benkuper/BenTo-Legacy/hardware/BentoPCB_V4_Front.png

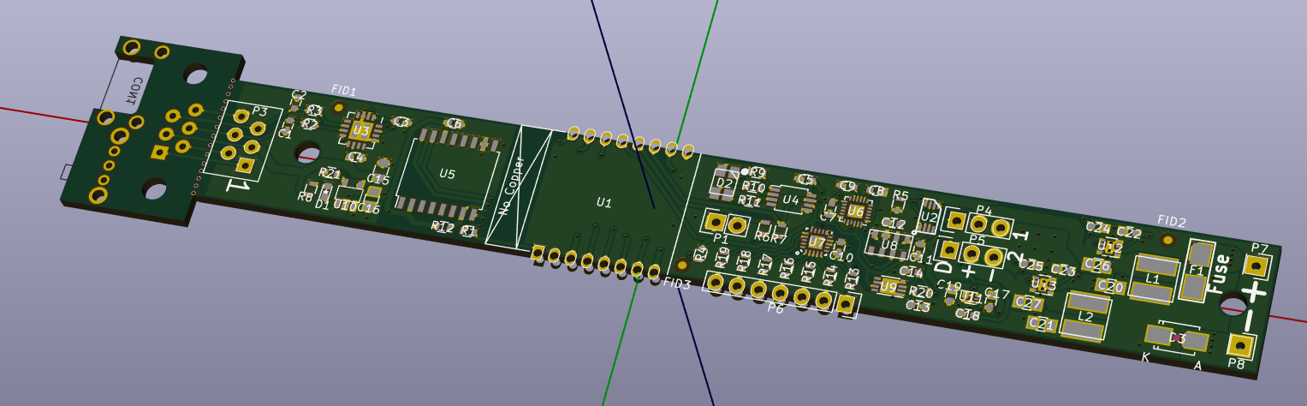
hardware/BentoPCB_V4_Front.png
