benkuper/BenTo-Legacy/hardware/BentoPCB_V4_Back.png

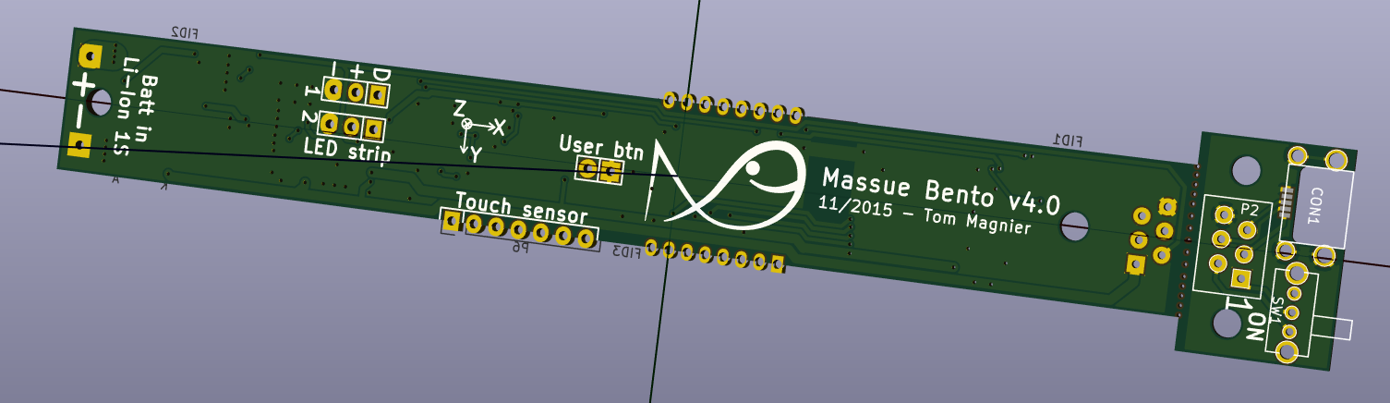
hardware/BentoPCB_V4_Back.png
