benkuper/BenTo-Legacy/README.md

# BenTo
Legacy repository for the Bento Clubs
