benkuper/BenTo-Legacy/hardware/BentoPCB_V4_layout.png

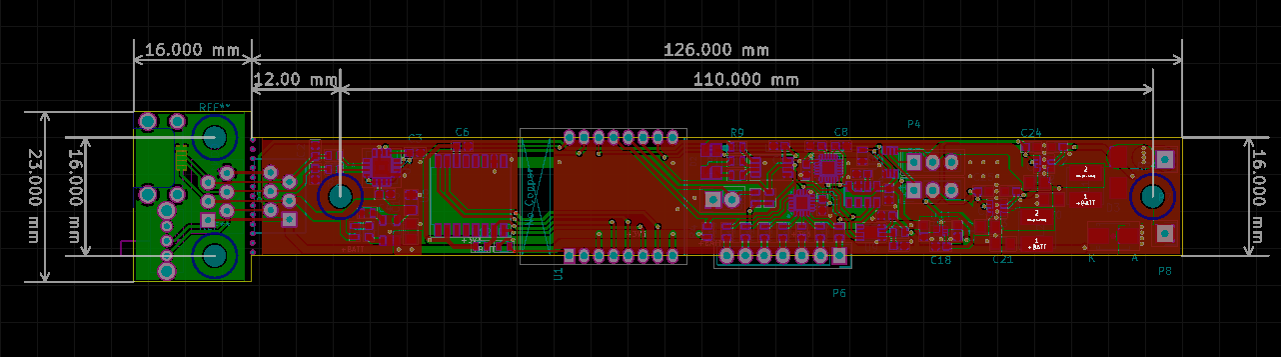
hardware/BentoPCB_V4_layout.png
