benkuper/BenTo-Legacy/hardware/prod/massue_bento_v4_BOM.ods

Reference | Qty | Designation | Package | Stock 17/06/16 | Mouser P/N | Mouser unit price (net, €, x1) | Mouser total price | Farnell P/N | Farnell unit price (net, €, x1) | Farnell total price
C1, C2 | 2 | 47pF | C_0603 | 2 | 77-VJ0603A470JXACBC (http://www.mouser.fr/ProductDetail/Vishay-Vitramon/VJ0603A470JXACW1BC/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) | 0,054 | 0,108 | 1759062 (http://fr.farnell.com/multicomp/mc0603n470j500ct/condensateur-mlcc-c0g-np0-47pf/dp/1759062) | 0,0097 | 0,0194
C3-C7,C9-C13,C18,C24,C25 | 13 | 0.1uF | C_0603 | 13 | VJ0603Y104JXJPW1BC (http://www.mouser.fr/ProductDetail/Vishay-Vitramon/VJ0603Y104JXJPW1BC/) | 0,054 | 0,702 | 1759037 (http://fr.farnell.com/multicomp/mc0603b104k250ct/condensateur-mlcc-0603-x7r-25v/dp/1759037) | 0,0073 | 0,0949
C8 | 1 | 10nF | C_0603 | 4 | VJ0603Y103KXAAC (http://www.mouser.fr/ProductDetail/Vishay-Vitramon/VJ0603Y103KXAAC/) | 0,045 | 0,045 | 1759102 (http://fr.farnell.com/multicomp/mc0603b103k500ct/condensateur-mlcc-0603-x7r-50v/dp/1759102) | 0,0073 | 0,0073
C14,C17,C19,C22,C23 | 5 | 2.2uF, 10V, X5R/X7R | C_0603 | 4 | 963-LMK107BJ225KA-T (http://www.mouser.fr/ProductDetail/Taiyo-Yuden/LMK107BJ225KA-T/) | 0,119 | 0,595 | 2320817 (http://fr.farnell.com/multicomp/mc0603x225k100ct/condensateur-mlcc-x5r-2-2uf-10v/dp/2320817) | 0,0214 | 0,107
C15,C16 | 2 | 10uF | C_0805 | 3 | 80-C0805C106M4P (http://www.mouser.fr/ProductDetail/Kemet/C0805C106M4PACTU/) | 0,19 | 0,38 | 2320856 (http://fr.farnell.com/multicomp/mc0805x106k160ct/condensateur-mlcc-x5r-10uf-16v/dp/2320856) | 0,0945 | 0,189
C20,C21 | 2 | 4.7uF, 10V, X5R/X7R | C_0805 | 3 | 81-GRM219R61C475KE5D (http://www.mouser.fr/ProductDetail/Murata-Electronics/GRM219R61C475KE15D/) | 0,154 | 0,308 | 1759420 (http://fr.farnell.com/multicomp/mc0805x475k100ct/condensateur-mlcc-x5r-4-7uf-10v/dp/1759420) | 0,0709 | 0,1418
C26,C27 | 2 | 22uF, 10V, ESR < 10mR, X5R/X7R | C_0805 | 3 | 603-CC805MKX5R6BB226 (http://www.mouser.fr/ProductDetail/Yageo/CC0805MKX5R6BB226/?qs=sGAEpiMZZMvsSlwiRhF8qmGKz53ivRjhfoOY2sHMRaQ%3D) | 0,274 | 0,548 | 2494270 (http://fr.farnell.com/murata/grm21br61a226me51l/condens-mlcc-x5r-22uf-10v-0805/dp/2494270) | 0,226 | 0,452
CON1 | 1 | USB-MICRO-B | Molex 47642-0001 |  | 538-47642-0001 (http://www.mouser.fr/ProductDetail/Molex/47642-0001/?qs=sGAEpiMZZMvix4Kz%252byXAvU6WIa4V4G4m) | 0,697 | 0,697 | 2396171 (http://fr.farnell.com/molex/47642-0001/connecteur-usb-micro-b-rcpt-5pos/dp/2396171) | 0,828 | 0,828
D1 | 1 | Red | LED-0603 | 7 |  | 0,091 | 0,091 | 8529833 (http://fr.farnell.com/kingbright/kp-1608sgc/led-cms-0603-vert/dp/8529833) | 0,079 | 0,079
D2 | 1 | Cree CLV1A | PLCC-4 |  | 941-V1AFKBCHMKPEH7A3 (http://www.mouser.fr/ProductDetail/Cree-Inc/CLV1A-FKB-CHMKPEHBB7A363/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) | 0,366 | 0,366 | 1855553 (http://fr.farnell.com/cree/clv1a-fkb-cj1m1f1bb7r4s3/led-plcc4-multi-colour/dp/1855553) | 0,505 | 0,505
D3 | 1 | PMEG4050EP | SMA_Standard |  | 771-PMEG4050EP115 (http://www.mouser.fr/ProductDetail/NXP-Semiconductors/PMEG4050EP115/) | 0,462 | 0,462 | 1829203 (http://fr.farnell.com/nxp/pmeg4050ep/diode-schottky-redr-40v-5a-sod128/dp/1829203) | 0,568 | 0,568
F1 | 1 | SMD FUSE, 8A | Fuse_SMD1206 | 1 | 637-F1206FA8000V024 (http://www.mouser.fr/ProductDetail/AEM/F1206FA8000V024T/) | 0,259 | 0,259 | 1843815 (http://fr.farnell.com/te-connectivity-raychem/1206sff800f-24-2/fuse-smd-1206-8a/dp/1843815) | 0,461 | 0,461
L1,L2 | 2 | 1uH, 4.5A (LQH5BPN1R0NT0L) | LQH5BP_Murata_ind |  | 81-LQH5BPN1R0NT0L0L (http://www.mouser.fr/ProductDetail/Murata-Electronics/LQH5BPN1R0NT0L/) | 0,443 | 0,886 | 2219299 (http://fr.farnell.com/murata/lqh5bpn1r0nt0l/inductance-puissance-1-0uh-30/dp/2219299) | 0,338 | 0,676
P2,P3 | 2 | CONN_01X06 | MOLEX 90325-0006 | 6 | 538-90325-0006 (http://www.mouser.fr/ProductDetail/Molex/90325-0006/?qs=sGAEpiMZZMulHKv6iWKM9N6rysiRsaER) | 0,33 | 0,66 | 673225 (http://fr.farnell.com/molex/90325-0006/embase-picoflex-6v/dp/673225) | 0,385 | 0,77
P2b | 1 |  | MOLEX 90327-0306 |  | 538-90327-0306 (http://www.mouser.fr/ProductDetail/Molex/90327-0306/?qs=sGAEpiMZZMvvAo%252bip5liN%252b%252bGt31S2ldP) | 0,659 | 0,659 | 673158 (http://fr.farnell.com/molex/90327-0306/connecteur-picoflex-6v/dp/673158) | 0,186 | 0,186
R1,R4-R7,R13-R19 | 12 | 10k | R_0603 | 9 | 71-CRCW0603-10K-E3 (http://www.mouser.fr/ProductDetail/Vishay-Dale/CRCW060310K0FKEA/) | 0,072 | 0,864 | 9238603 (http://fr.farnell.com/yageo-phycomp/rc0603fr-0710kl/resistance-rc22h-0603-10k/dp/9238603) | 0,0064 | 0,0768
R2,R3 | 2 | 27R | R_0603 | 3 | 71-CRCW060327R0JNEB (http://www.mouser.fr/ProductDetail/Vishay-Dale/CRCW060327R0JNEB/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) | 0,072 | 0,144 | 2447316 (http://fr.farnell.com/multicomp/mcwr06x27r0ftl/resistance-couche-epaisse-27r/dp/2447316) | 0,0013 | 0,0026
R8 | 1 | 1k | R_0603 | 4 | 71-CRCW0603-1.0K-E3 (http://www.mouser.fr/ProductDetail/Vishay-Dale/CRCW06031K00FKEA/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) | 0,072 | 0,072 | 9330380 (http://fr.farnell.com/multicomp/mc0063w060311k/resistance-1k-0-063w-1-0603/dp/9330380) | 0,037 | 0,037
R9 | 1 | 220R | R_0603 | 5 | 594-MCT06030C2200FP5 (http://www.mouser.fr/ProductDetail/Vishay-Beyschlag/MCT06030C2200FP500/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) | 0,054 | 0,054 | 1652858 (http://fr.farnell.com/vishay-draloric/crcw0603220rjnea/resistance-couche-epaisse/dp/1652858) | 0,0064 | 0,0064
R10,R11 | 2 | 100R | R_0603 |  | 71-CRCW0603-100-E3 (http://www.mouser.fr/ProductDetail/Vishay-Dale/CRCW0603100RFKEA/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) | 0,072 | 0,144 | 9330364 (http://fr.farnell.com/multicomp/mc0063w06031100r/resistance-0603-100r/dp/9330364) | 0,007 | 0,014
R12 | 1 | 100k | R_0603 | 5 | 71-CRCW0603-100K-E3 (http://www.mouser.fr/ProductDetail/Vishay-Dale/CRCW0603100KFKEA/) | 0,072 | 0,072 | 9330402 (http://fr.farnell.com/multicomp/mc0063w06031100k/resistance-100k-0-063w-1-0603/dp/9330402) | 0,037 | 0,037
R21 | 1 | 2k | R_0603 | 6 | 71-CRCW0603-2.0K-E3 (http://www.mouser.fr/ProductDetail/Vishay-Dale/CRCW06032K00FKEA/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) | 0,091 | 0,091 | 9330763 (http://fr.farnell.com/multicomp/mc0063w060312k/resistance-2k-0-063w-1-0603/dp/9330763) | 0,012 | 0,012
SW1 | 1 | SWITCH_INV | OS102011MA1QN1 |  | 611-OS102011MA1QN1 (http://www.mouser.fr/ProductDetail/CK-Components/0S102011MA1QN1/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) | 0,42 | 0,42 | 1201431 (http://fr.farnell.com/c-k-components/os102011ma1qn1/emission-laterale-commutateur/dp/1201431) | 0,675 | 0,675
U1 | 1 | ESP-07v2 | ESP-07v2 |  |  |  | 0 |  |  | 0
U2 | 1 | SN74LVC2T45DCU | VSSOP-8 |  | 595-SN74LVC2T45DCUR (http://www.mouser.fr/ProductDetail/Texas-Instruments/SN74LVC2T45DCUR/) | 0,652 | 0,652 | 2499858 (http://fr.farnell.com/texas-instruments/sn74lvc2t45qdcurq1/transceiver-2bits-sortie-3-etats/dp/2499858) | 0,511 | 0,511
U3 | 1 | FT230XQ | QFN-16-1EP_4x4mm_Pitch0.65mm |  | 895-FT230XQ-R (http://www.mouser.fr/ProductDetail/FTDI/FT230XQ-R/?qs=sGAEpiMZZMvVkErl6zY%252bqeI5xuGNHfx4) | 1,87 | 1,87 | 2081324 (http://fr.farnell.com/ftdi/ft230xq/i-f-usb2-0-fs-to-bascircuit-uart/dp/2081324) | 1,94 | 1,94
U4 | 1 | PCA9632DP1 | TSSOP-8_3x3mm_Pitch0.65mm |  | 771-PCA9632DP1118 (http://www.mouser.fr/ProductDetail/NXP-Semiconductors/PCA9632DP1118/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) | 1,26 | 1,26 |  |  | 0
U5 | 1 | S25FL512S**M | SOIC-16_7.5x10.3mm_Pitch1.27mm |  | 797-25FL512SAGMFIG11 (http://www.mouser.fr/ProductDetail/Spansion/S25FL512SAGMFIG11/) | 5,39 | 5,39 | 2340548 (http://fr.farnell.com/spansion/s25fl512sagmfig11/memoire-flash-512mb-16soic/dp/2340548) | 6,73 | 6,73
U6 | 1 | MPU9250 | QFN-24-1EP_3x3mm_Pitch0.4mm |  |  |  | 0 |  |  | 0
U7 | 1 | AT42QT1070-MMH | QFP_20_3x3mm_0.45mm_pitch |  | 556-AT42QT1070-MMH (http://www.mouser.fr/ProductDetail/Atmel/AT42QT1070-MMH/) | 1,74 | 1,74 |  |  | 0
U8 | 1 | MPL3115A2 | LGA8 |  | 841-MPL3115A2 (http://www.mouser.fr/ProductDetail/Freescale-Semiconductor/MPL3115A2/?qs=sGAEpiMZZMu5STvjs3TtKqOY2b8Izg8b) | 2,98 | 2,98 | 2009084 (http://fr.farnell.com/freescale-semiconductor/mpl3115a2/pressure-sensor-20-110kpa-8lga/dp/2009084) | 2,64 | 2,64
U9 | 1 | LC709203F | WDFN-8-1EP_3x4mm_Pitch0.65mm |  | 863-LC709203FQH01TWG (http://www.mouser.fr/ProductDetail/ON-Semiconductor/LC709203FQH-01TWG/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) | 1,47 | 1,47 |  |  | 0
U10 | 1 | MCP73832***/OT | SOT-23-5 | 2 | 579-MCP73832T2DFI/OT (http://www.mouser.fr/ProductDetail/Microchip-Technology/MCP73832T-2DFI-OT/?qs=sGAEpiMZZMvAvBNgSS9Lqry4bkuQioGQ) | 0,543 | 0,543 | 1834892 (http://fr.farnell.com/microchip/mcp73832t-2dci-ot/batt-charger-li-ion-li-poly-5sot23/dp/1834892) | 0,53 | 0,53
U11 | 1 | MIC5528-3.3YMT | DFN-6-1EP_1.2x1.2mm_Pitch0.4mm | 2 | 998-MIC5528-3.3YMTTR (http://www.mouser.fr/ProductDetail/Micrel/MIC5528-33YMT-TR/) | 0,525 | 0,525 | 2451762 (http://fr.farnell.com/micrel-semiconductor/mic5528-3-3ymt-tr/ldo-volt-reg-0-5a-3-3v-tdfn-6/dp/2451762) | 0,238 | 0,238
U12,U13 | 2 | MIC2876-5.0YMT | DFN-8-1EP_2x2mm_Pitch0.5mm | 2 | 998-MIC2876-50YMTT5 (http://www.mouser.fr/ProductDetail/Micrel/MIC2876-50YMT-T5/?qs=sGAEpiMZZMvJkDqKJH80dCXDytGmYK1ioJlrXRr9Mlw%3D) | 1,45 | 2,9 |  |  | 0
TOTAL |  |  |  |  |  |  | 27,957 |  |  | 18,5342
acheter en plus : nappe |  |  |  |  | 538-92315-0620 (http://www.mouser.fr/ProductDetail/Molex/92315-0620/?qs=sGAEpiMZZMuw1rG4%252bG7fppmX45GF4%252bkx) | 1,24 |  | 3032140 | 1,86
