benkuper/BenTo-Legacy/hardware/massue_bento_v4.pdf

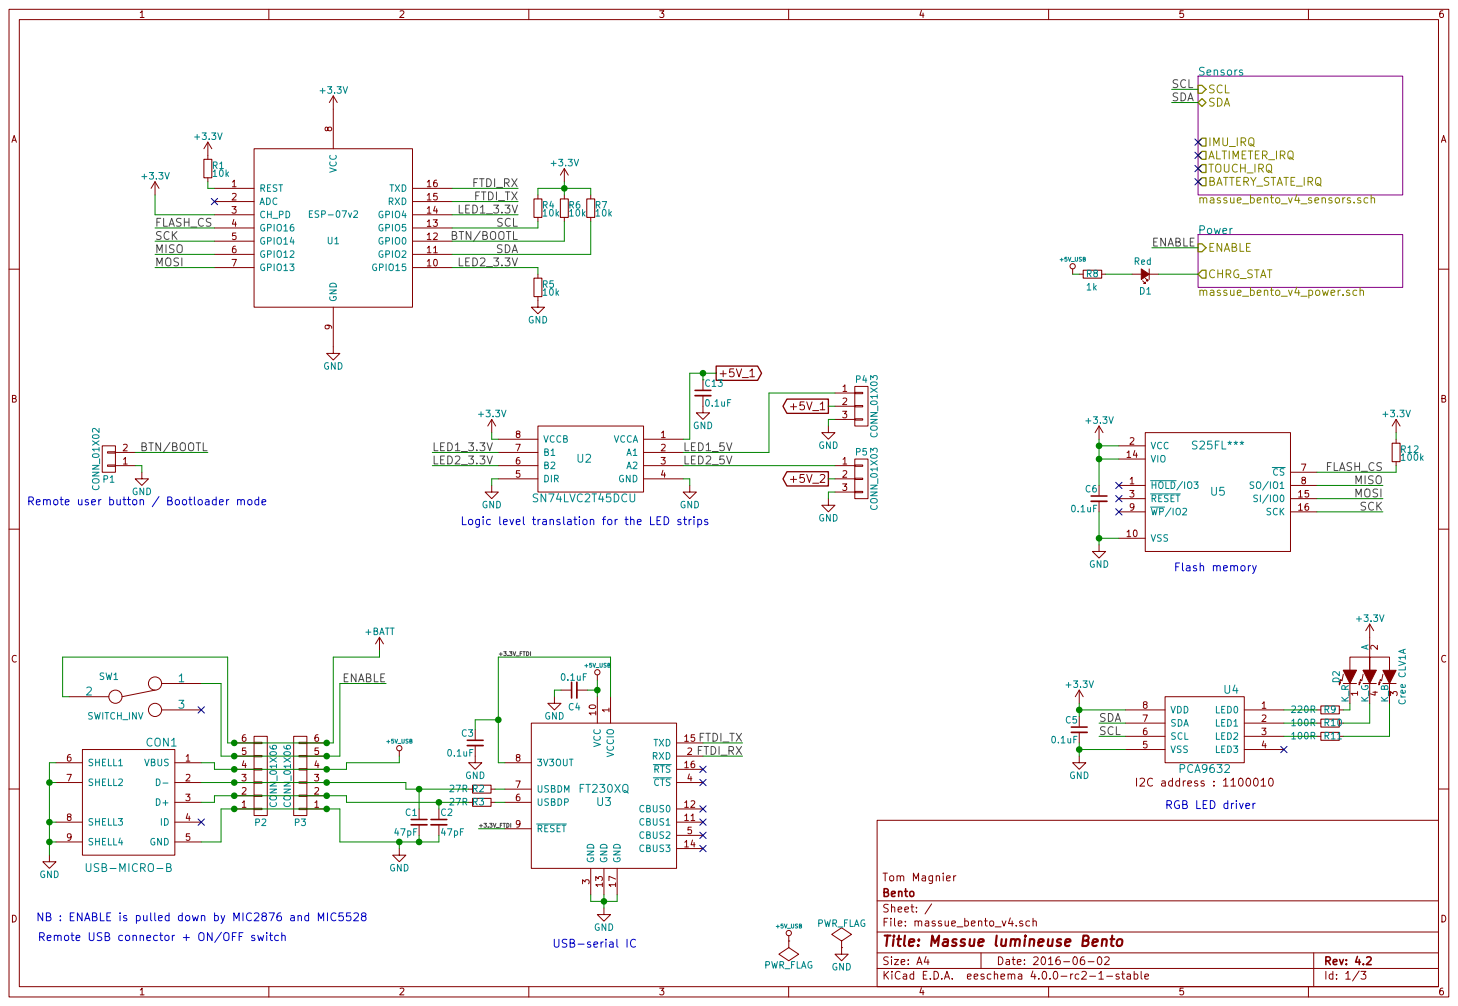
[picture p4: page 1]

9 GPIO15 10 GPIO2 11 GPIO0 12 GPIO5 13 GPIO4 14 RXD 15 TXD 16 U1 ESP-07v2 HOLD/IO3 1 VCC 2 RESET 3 CS 7 SO/IO1 8 WP/IO2 9 VSS 10 VIO 14 SI/IO0 15 SCK 16 U5 S25FL*** VBUS 1 D- 2 D+ 3
10k GND FLASH_CS

Remote user button / Bootloader mode

Logic level translation for the LED strips

Tom Magnier
File: massue_bento_v4.sch Sheet: / Bento

Id: 1/3 Title: Massue lumineuse Bento

Remote USB connector + ON/OFF switch

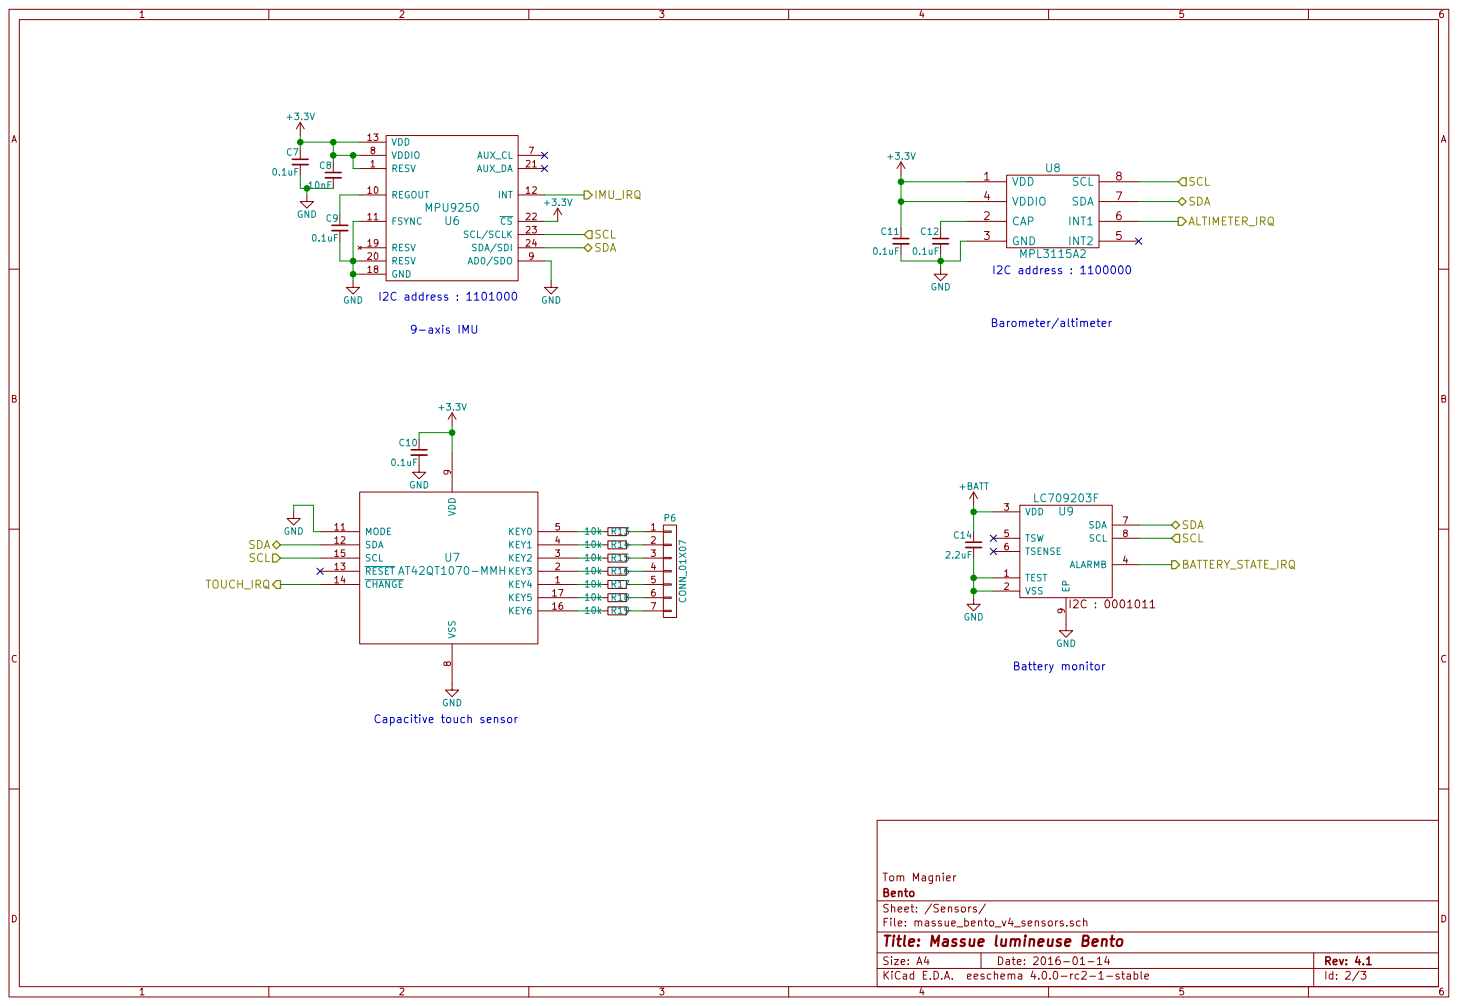
[picture p5: page 2]

9 MODE 11 SDA 12 RESET 13 CHANGE 14 SCL 15 KEY6 16 KEY5 17 U7 AT42QT1070-MMH

Capacitive touch sensor GND GND SCL
SDA

Tom Magnier
File: massue_bento_v4_sensors.sch Sheet: /Sensors/ Bento

Id: 2/3 Title: Massue lumineuse Bento

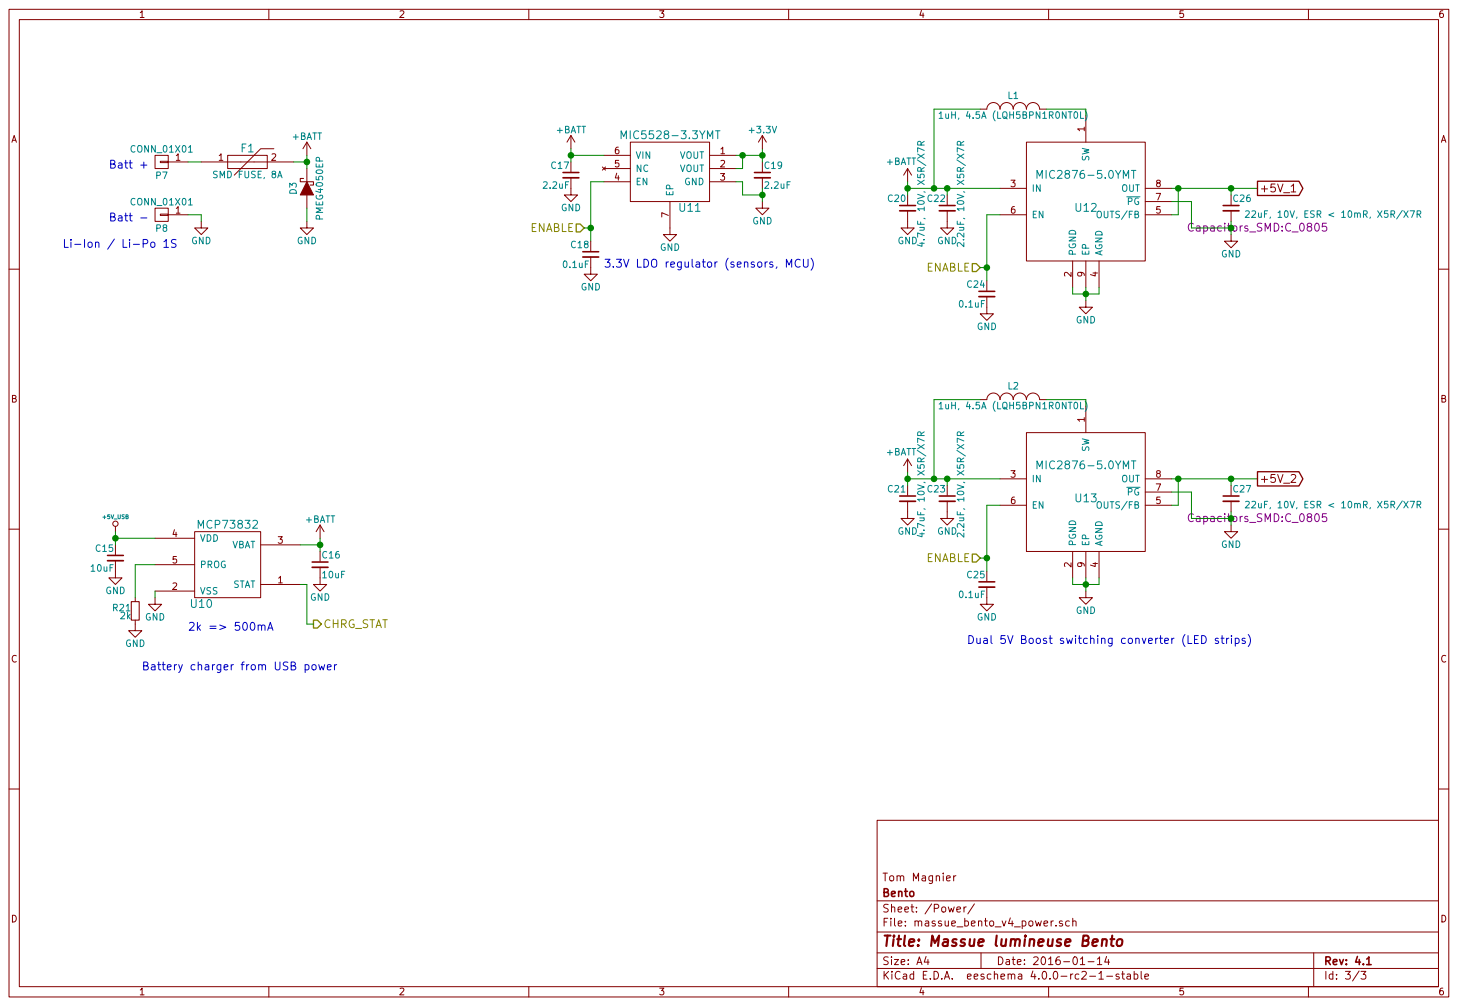
[picture p6: page 3]

1 P8 CONN_01X01 Batt + Batt - Li-Ion / Li-Po 1S

4 OUTS/FB 5 EN 6 PG 7 OUT 8 EP

3.3V LDO regulator (sensors, MCU) GND

10uF GND Battery charger from USB power

GND
Dual 5V Boost switching converter (LED strips)

File: massue_bento_v4_power.sch Sheet: /Power/ Bento

Id: 3/3 Title: Massue lumineuse Bento
