benkuper/BenTo-Legacy/hardware/prod/massue_bento_v4-brd.pdf

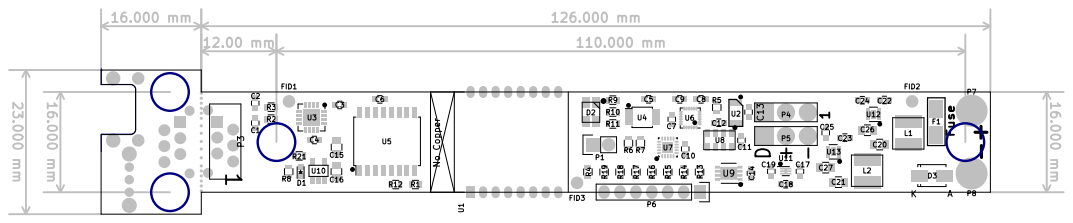
[picture p7: page 1]
