benkuper/BenTo-Legacy/hardware/massue_bento_v4.kicad_pcb

## KiCad design hardware/massue_bento_v4.kicad_pcb (2017-02-13)

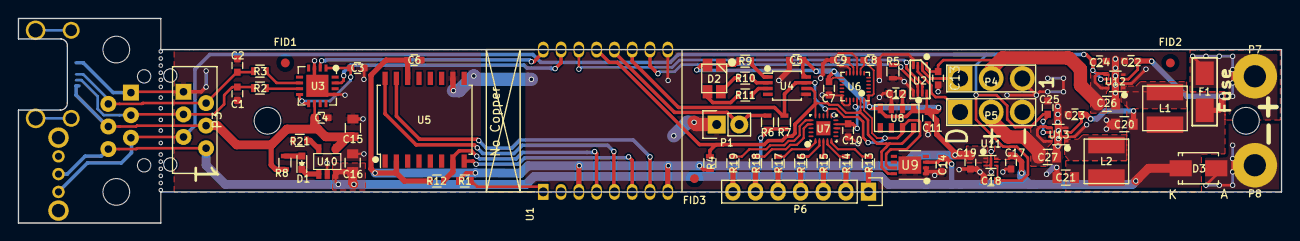
[picture p8: board massue_bento_v4.kicad_pcb from above]

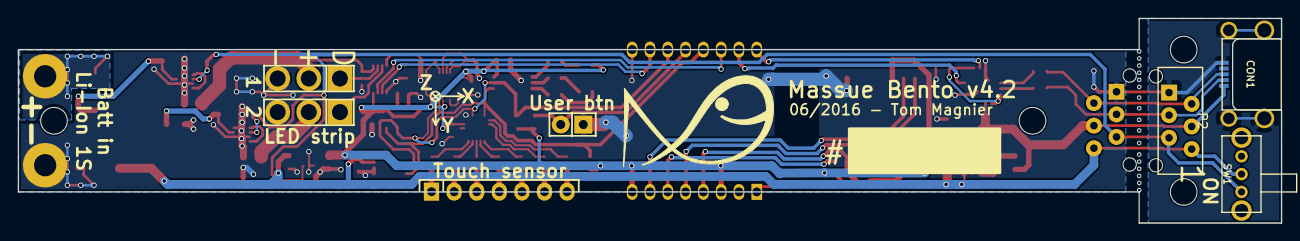
[picture p9: board massue_bento_v4.kicad_pcb from below]

Board: 2 copper layers, 142.0 x 23.0 mm, 79 parts (3 on the bottom side), 54 nets.

Parts:
C1, C2: 47pF; C_0603
C3, C4, C5, C6, C7, C9, C10, C11, C12, C13, C18, C24, C25: 0.1uF; C_0603
C8: 10nF; C_0603
C14, C17, C19: 2.2uF; C_0603
C15, C16: 10uF; C_0805
C20, C21: 4.7uF, 10V, X5R/X7R; C_0805
C22, C23: 2.2uF, 10V, X5R/X7R; C_0603
C26, C27: 22uF, 10V, ESR < 10mR, X5R/X7R; C_0805
CON1: USB-MICRO-B; MICRO_USB_B_MIDMOUNT_TH
D1: Red; LED-0603
D2: Cree CLV1A; PLCC-4
D3: PMEG4050EP; SMA_Standard
F1: SMD FUSE, 8A; Fuse_SMD1206_HandSoldering
FID1, FID2, FID3: Fiducial_very_small_modern
L1, L2: 1uH, 4.5A (LQH5BPN1R0NT0L); LQH5BP_Murata_ind
P1: CONN_01X02; Socket_Strip_Straight_1x02
P2, P3: CONN_01X06; MOLEX_90325-0006
P4, P5: CONN_01X03; Conn_1x03_1-8mmDrill
P6: CONN_01X07; Socket_Strip_Straight_1x07
P7, P8: CONN_01X01; SolderWirePad_single_2-5mmDrill
R1, R4, R5, R6, R7, R13, R14, R15, R16, R17, R18, R19: 10k; R_0603
R2, R3: 27R; R_0603
R8: 1k; R_0603
R9: 220R; R_0603
R10, R11: 100R; R_0603
R12: 100k; R_0603
R21: 2k; R_0603
SW1: SWITCH_INV; SPDT_MINI_SLIDE_SWITCH
U1: ESP-07v2
U2: SN74LVC2T45DCU; VSSOP-8
U3: FT230XQ; QFN-16-1EP_4x4mm_Pitch0.65mm
U4: PCA9632; TSSOP-8_3x3mm_Pitch0.65mm
U5: S25FL***; SOIC-16_7.5x10.3mm_Pitch1.27mm
U6: MPU9250; QFN-24-3x3mm_Pitch0.4mm
U7: AT42QT1070-MMH; QFP_20_3x3mm_0.45mm_pitch
U8: MPL3115A2; LGA8
U9: LC709203F; WDFN-8-1EP_3x4mm_Pitch0.65mm
U10: MCP73832; SOT-23-5
U11: MIC5528-3.3YMT; DFN-6-1EP_1.2x1.2mm_Pitch0.4mm
U12, U13: MIC2876-5.0YMT; DFN-8-1EP_2x2mm_Pitch0.5mm

Connections:
+3V3: C5.1, C6.1, C7.1, C8.1, C10.1, C11.1, C19.1, D2.2, R1.1, R4.1, R6.1, R7.1, R12.1, U1.3, U1.8, U2.8, U4.8, U5.2, U5.14, U6.1, U6.8, U6.13, U6.22, U7.9, U8.1, U8.4, U11.1, U11.2
+5V_1: C13.1, C26.1, P4.2, U2.1, U12.5, U12.8
+5V_2: C27.1, P5.2, U13.5, U13.8
+5V_USB: C4.2, C15.1, CON1.1, P2.4, P3.4, R8.2, U3.10, U10.4
+BATT: C14.1, C16.1, C17.1, C20.1, C21.1, C22.1, C23.1, D3.1, F1.2, L1.1, L2.1, P2.6, P3.6, SW1.2, U9.3, U10.3, U11.6, U12.3, U13.3
/+3.3V_FTDI: C3.1, U3.1, U3.8, U3.9
/BTN/BOOTL: P1.2, R6.2, U1.12
/FLASH_CS: R12.2, U1.4, U5.7
/FTDI_RX: U1.16, U3.2
/FTDI_TX: U1.15, U3.15
/LED1_3.3V: U1.14, U2.7
/LED1_5V: P4.1, U2.2
/LED2_3.3V: R5.1, U1.10, U2.6
/LED2_5V: P5.1, U2.3
/MISO: U1.6, U5.8
/MOSI: U1.7, U5.15
/Power/CHRG_STAT: D1.1, U10.1
/Power/ENABLE: C18.1, C24.1, C25.1, P2.5, P3.5, SW1.1, U11.4, U12.6, U13.6
/SCK: U1.5, U5.16
/Sensors/SCL: R4.2, U1.13, U4.6, U6.23, U7.15, U8.8, U9.8
/Sensors/SDA: R7.2, U1.11, U4.7, U6.24, U7.12, U8.7, U9.7
GND: C1.2, C2.2, C3.2, C4.1, C5.2, C6.2, C7.2, C8.2, C9.2, C10.2, C11.2, C12.2, C13.2, C14.2, C15.2, C16.2, C17.2, C18.2, C19.2, C20.2, C21.2, C22.2, C23.2, C24.2, C25.2, C26.2, C27.2, CON1.5, CON1.6, CON1.7, CON1.8, CON1.9, D3.2, P1.1, P2.1, P3.1, P4.3, P5.3, P8.1, R5.2, R21.2, U1.9, U2.4, U2.5, U3.3, U3.13, U3.17, U4.5, U5.10, U6.9, U6.11, U6.18, U6.20, U7.8, U7.11, U8.3, U9.1, U9.2, U9.9, U10.2, U11.3, U11.7, U12.2, U12.4, U12.7, U12.9, U13.2, U13.4, U13.7, U13.9
unnamed: C1.1, CON1.2, P2.3, P3.3, R2.2
unnamed: C2.1, CON1.3, P2.2, P3.2, R3.2
unnamed: C9.1, U6.10
unnamed: C12.1, U8.2
unnamed: D1.2, R8.1
unnamed: D2.1, R9.1
unnamed: D2.3, R11.1
unnamed: D2.4, R10.1
unnamed: F1.1, P7.1
unnamed: L1.2, U12.1
unnamed: L2.2, U13.1
unnamed: P6.1, R13.1
unnamed: P6.2, R14.1
unnamed: P6.3, R15.1
unnamed: P6.4, R16.1
unnamed: P6.5, R17.1
unnamed: P6.6, R18.1
unnamed: P6.7, R19.1
unnamed: R1.2, U1.1
unnamed: R2.1, U3.7
unnamed: R3.1, U3.6
unnamed: R9.2, U4.1
unnamed: R10.2, U4.2
unnamed: R11.2, U4.3
unnamed: R13.2, U7.5
unnamed: R14.2, U7.4
unnamed: R15.2, U7.3
unnamed: R16.2, U7.2
unnamed: R17.2, U7.1
unnamed: R18.2, U7.17
unnamed: R19.2, U7.16
unnamed: R21.1, U10.5
